the-ress/dmx-box/assets/xlr_pinouts_license.md

This file is licensed under the Creative Commons Attribution-Share Alike 3.0 Unported,
2.5 Generic, 2.0 Generic and 1.0 Generic license.

https://commons.wikimedia.org/wiki/File:XLR_pinouts.svg

Author: https://commons.wikimedia.org/wiki/User:Omegatron
