the-ress/dmx-box/pcb/jlcpcb-gerbers-v1/dmx-box-rounded_drill_map.png

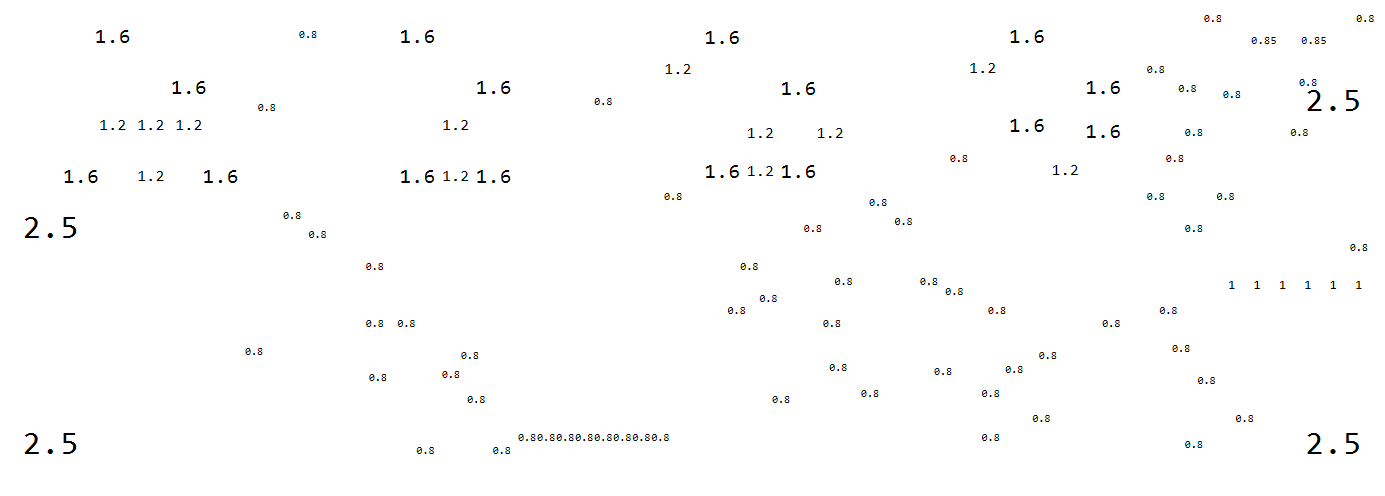
pcb/jlcpcb-gerbers-v1/dmx-box-rounded_drill_map.png
