the-ress/dmx-box/pcb/dmx-box.xlsx

Source: | C:\Users\Tereza\Documents\KiCad\dmx-box\dmx-box.kicad_sch
Date: | 2022-12-01 19:48
Tool: | Eeschema (6.0.9)
Generator: | C:\Program Files\KiCad\6.0\bin\scripting\plugins/bom_csv_grouped_by_value.py
Component Count: | 47
Individual Components:
Item | Qty | Reference(s) | Value | LibPart | Footprint |  |  | Datasheet
 |  | C1 | 100 nF | Device:C | Capacitor_SMD:C_0805_2012Metric |  |  | ~
 |  | C2 | 100 nF | Device:C | Capacitor_SMD:C_0805_2012Metric |  |  | ~
 |  | C3 | 10 uF | Device:C | Capacitor_SMD:C_0805_2012Metric |  |  | ~
 |  | C4 | 100 nF | Device:C | Capacitor_SMD:C_0805_2012Metric |  |  | ~
 |  | C5 | 100 nF | Device:C | Capacitor_SMD:C_0805_2012Metric |  |  | ~
 |  | C6 | 100 nF | Device:C | Capacitor_SMD:C_0805_2012Metric |  |  | ~
 |  | C7 | 100 nF | Device:C | Capacitor_SMD:C_0805_2012Metric |  |  | ~
 |  | C8 | 10 uF | Device:C | Capacitor_SMD:C_0805_2012Metric |  |  | ~
 |  | C9 | 1 uF | Device:C | Capacitor_SMD:C_0805_2012Metric |  |  | ~
 |  | D1 | PWR LED | Device:LED | LED_SMD:LED_0805_2012Metric |  |  | ~
 |  | D2 | DMX OUT LED | Device:LED | LED_SMD:LED_0805_2012Metric |  |  | ~
 |  | D3 | DMX IN LED | Device:LED | LED_SMD:LED_0805_2012Metric |  |  | ~
 |  | D4 | ARTNET IN LED | Device:LED | LED_SMD:LED_0805_2012Metric |  |  | ~
 |  | D5 | WIFI AP LED | Device:LED | LED_SMD:LED_0805_2012Metric |  |  | ~
 |  | D6 | WIFI CLIENT LED | Device:LED | LED_SMD:LED_0805_2012Metric |  |  | ~
 |  | H1 | MountingHole | Mechanical:MountingHole | MountingHole:MountingHole_2.5mm |  |  | ~
 |  | H2 | MountingHole | Mechanical:MountingHole | MountingHole:MountingHole_2.5mm |  |  | ~
 |  | H3 | MountingHole | Mechanical:MountingHole | MountingHole:MountingHole_2.5mm |  |  | ~
 |  | H4 | MountingHole | Mechanical:MountingHole | MountingHole:MountingHole_2.5mm |  |  | ~
 |  | J1 | XLR3_Out | Connector:XLR3_Ground | Connector_Audio:Jack_XLR_Neutrik_NC3FAH2_Horizontal |  |  | ~
 |  | J2 | XLR5_Out | Connector:XLR6 | Connector_Audio:Jack_XLR_Neutrik_NC5FAH_Horizontal |  |  | ~
 |  | J3 | XLR3_In | Connector:XLR3_Ground | Connector_Audio:Jack_XLR_Neutrik_NC3MAH_Horizontal |  |  | ~
 |  | J4 | XLR5_In | Connector:XLR6 | Connector_Audio:Jack_XLR_Neutrik_NC5MAH_Horizontal |  |  | ~
 |  | J5 | USB_B_Micro | Connector:USB_B_Micro | Connector_USB:USB_Micro-B_Molex-105017-0001 |  |  | ~
 |  | J6 | FLASH | Connector_Generic:Conn_01x06 | Connector_PinHeader_2.54mm:PinHeader_1x06_P2.54mm_Vertical |  |  | ~
 |  | Q1 | BCR108 | Transistor_BJT_Pre-Biased_AKL:BCR108 | Package_TO_SOT_SMD_AKL:SOT-23 |  |  | https://www.tme.eu/Document/25cb4b9a0415796c4b98bc4cbdcfd7ac/BCR108WH6327.pdf
 |  | Q2 | BCR108 | Transistor_BJT_Pre-Biased_AKL:BCR108 | Package_TO_SOT_SMD_AKL:SOT-23 |  |  | https://www.tme.eu/Document/25cb4b9a0415796c4b98bc4cbdcfd7ac/BCR108WH6327.pdf
 |  | R1 | 10K | Device:R | Resistor_SMD:R_0805_2012Metric |  |  | ~
 |  | R2 | 20K | Device:R | Resistor_SMD:R_0805_2012Metric |  |  | ~
 |  | R3 | 20K | Device:R | Resistor_SMD:R_0805_2012Metric |  |  | ~
 |  | R4 | 120 | Device:R | Resistor_SMD:R_0805_2012Metric |  |  | ~
 |  | R5 | 120 | Device:R | Resistor_SMD:R_0805_2012Metric |  |  | ~
 |  | R6 | 10K | Device:R | Resistor_SMD:R_0805_2012Metric |  |  | ~
 |  | R7 | 10K | Device:R | Resistor_SMD:R_0805_2012Metric |  |  | ~
 |  | R8 | 330 | Device:R | Resistor_SMD:R_0805_2012Metric |  |  | ~
 |  | R9 | 330 | Device:R | Resistor_SMD:R_0805_2012Metric |  |  | ~
 |  | R10 | 330 | Device:R | Resistor_SMD:R_0805_2012Metric |  |  | ~
 |  | R11 | 330 | Device:R | Resistor_SMD:R_0805_2012Metric |  |  | ~
 |  | R12 | 330 | Device:R | Resistor_SMD:R_0805_2012Metric |  |  | ~
 |  | R13 | 330 | Device:R | Resistor_SMD:R_0805_2012Metric |  |  | ~
 |  | SW1 | SW ZERO | Switch:SW_Push | Tereza_custom:SW_Push_TD-03XA-T |  |  | ~
 |  | SW2 | SW RESET | Switch:SW_Push | Tereza_custom:SW_Push_TD-03XA-T |  |  | ~
 |  | U1 | SN75176AD_Out | Interface_UART:SN75176AD | Package_SO:SOIC-8_3.9x4.9mm_P1.27mm |  |  | http://www.ti.com/lit/ds/symlink/sn75176a.pdf
 |  | U2 | SN75176AD_In | Interface_UART:SN75176AD | Package_SO:SOIC-8_3.9x4.9mm_P1.27mm |  |  | http://www.ti.com/lit/ds/symlink/sn75176a.pdf
 |  | U3 | ESP32-WROOM-32U | RF_Module:ESP32-WROOM-32U | RF_Module:ESP32-WROOM-32U |  |  | https://www.espressif.com/sites/default/files/documentation/esp32-wroom-32d_esp32-wroom-32u_datasheet_en.pdf
 |  | U4 | CH340C | Interface_USB:CH340C | Package_SO:SOIC-16_3.9x9.9mm_P1.27mm |  |  | https://datasheet.lcsc.com/szlcsc/Jiangsu-Qin-Heng-CH340C_C84681.pdf
 |  | U5 | NCP1117-3.3_SOT223 | Regulator_Linear:NCP1117-3.3_SOT223 | Package_TO_SOT_SMD:SOT-223-3_TabPin2 |  |  | http://www.onsemi.com/pub_link/Collateral/NCP1117-D.PDF
Collated Components:
Item | Qty | Reference(s) | Value | LibPart | Footprint | Price | Subtotal | Datasheet
1 | 6 | C1, C2, C4, C5, C6, C7 | 100 nF | Device:C | Capacitor_SMD:C_0805_2012Metric | 2.9 | 17.4 | ~
2 | 2 | C3, C8 | 10 uF | Device:C | Capacitor_SMD:C_0805_2012Metric | 2.1 | 4.2 | ~
3 | 1 | C9 | 1 uF | Device:C | Capacitor_SMD:C_0805_2012Metric | 2.8 | 2.8 | ~
4 | 1 | D1 | PWR LED | Device:LED | LED_SMD:LED_0805_2012Metric | 1.4 | 1.4 | ~
5 | 1 | D2 | DMX OUT LED | Device:LED | LED_SMD:LED_0805_2012Metric | 1.4 | 1.4 | ~
6 | 1 | D3 | DMX IN LED | Device:LED | LED_SMD:LED_0805_2012Metric | 1.4 | 1.4 | ~
7 | 1 | D4 | ARTNET IN LED | Device:LED | LED_SMD:LED_0805_2012Metric | 1.4 | 1.4 | ~
8 | 1 | D5 | WIFI AP LED | Device:LED | LED_SMD:LED_0805_2012Metric | 1.4 | 1.4 | ~
9 | 1 | D6 | WIFI CLIENT LED | Device:LED | LED_SMD:LED_0805_2012Metric | 1.4 | 1.4 | ~
10 | 4 | H1, H2, H3, H4 | MountingHole | Mechanical:MountingHole | MountingHole:MountingHole_2.5mm | 0 | 0 | ~
11 | 1 | J1 | XLR3_Out | Connector:XLR3_Ground | Connector_Audio:Jack_XLR_Neutrik_NC3FAH2_Horizontal | 89.2 | 89.2 | ~
12 | 1 | J2 | XLR5_Out | Connector:XLR6 | Connector_Audio:Jack_XLR_Neutrik_NC5FAH_Horizontal | 141.2 | 141.2 | ~
13 | 1 | J3 | XLR3_In | Connector:XLR3_Ground | Connector_Audio:Jack_XLR_Neutrik_NC3MAH_Horizontal | 72.3 | 72.3 | ~
14 | 1 | J4 | XLR5_In | Connector:XLR6 | Connector_Audio:Jack_XLR_Neutrik_NC5MAH_Horizontal | 158.1 | 158.1 | ~
15 | 1 | J5 | USB_B_Micro | Connector:USB_B_Micro | Connector_USB:USB_Micro-B_Molex-105017-0001 | 24.1 | 24.1 | ~
16 | 1 | J6 | FLASH | Connector_Generic:Conn_01x06 | Connector_PinHeader_2.54mm:PinHeader_1x06_P2.54mm_Vertical | 1.1 | 1.1 | ~
17 | 2 | Q1, Q2 | BCR108 | Transistor_BJT_Pre-Biased_AKL:BCR108 | Package_TO_SOT_SMD_AKL:SOT-23 | 1.7 | 3.4 | https://www.tme.eu/Document/25cb4b9a0415796c4b98bc4cbdcfd7ac/BCR108WH6327.pdf
18 | 3 | R1, R6, R7 | 10K | Device:R | Resistor_SMD:R_0805_2012Metric | 2 | 6 | ~
19 | 2 | R2, R3 | 20K | Device:R | Resistor_SMD:R_0805_2012Metric | 2 | 4 | ~
20 | 2 | R4, R5 | 120 | Device:R | Resistor_SMD:R_0805_2012Metric | 2 | 4 | ~
21 | 6 | R8, R9, R10, R11, R12, R13 | 330 | Device:R | Resistor_SMD:R_0805_2012Metric | 2 | 12 | ~
22 | 1 | SW1 | SW ZERO | Switch:SW_Push | Tereza_custom:SW_Push_TD-03XA-T | 2.4 | 2.4 | ~
23 | 1 | SW2 | SW RESET | Switch:SW_Push | Tereza_custom:SW_Push_TD-03XA-T | 2.4 | 2.4 | ~
24 | 1 | U1 | SN75176AD_Out | Interface_UART:SN75176AD | Package_SO:SOIC-8_3.9x4.9mm_P1.27mm | 28 | 28 | http://www.ti.com/lit/ds/symlink/sn75176a.pdf
25 | 1 | U2 | SN75176AD_In | Interface_UART:SN75176AD | Package_SO:SOIC-8_3.9x4.9mm_P1.27mm | 28 | 28 | http://www.ti.com/lit/ds/symlink/sn75176a.pdf
26 | 1 | U3 | ESP32-WROOM-32U | RF_Module:ESP32-WROOM-32U | RF_Module:ESP32-WROOM-32U | 182.1 | 182.1 | https://www.espressif.com/sites/default/files/documentation/esp32-wroom-32d_esp32-wroom-32u_datasheet_en.pdf
27 | 1 | U4 | CH340C | Interface_USB:CH340C | Package_SO:SOIC-16_3.9x9.9mm_P1.27mm | 16.5 | 16.5 | https://datasheet.lcsc.com/szlcsc/Jiangsu-Qin-Heng-CH340C_C84681.pdf
28 | 1 | U5 | NCP1117-3.3_SOT223 | Regulator_Linear:NCP1117-3.3_SOT223 | Package_TO_SOT_SMD:SOT-223-3_TabPin2 | 10.4 | 10.4 | http://www.onsemi.com/pub_link/Collateral/NCP1117-D.PDF
 | 1 |  |  |  | Board | 37.9 | 37.9
 | 1 |  |  |  | Box | 58.9 | 58.9
 |  |  |  |  |  |  | 914.8
