the-ress/dmx-box/pcb/dmx-box.step

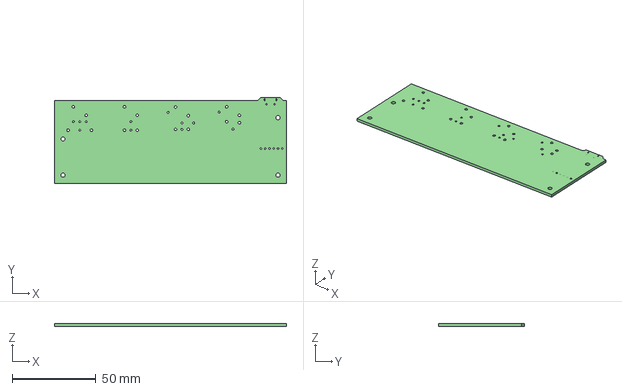
[picture p3: CAD file, 2025-04-09]
pcb/dmx-box.step
138.4 x 51.4 x 1.60 mm
