the-ress/dmx-box/pcb/dmx-box.kicad_pcb

## KiCad design pcb/dmx-box.kicad_pcb (2025-04-09)

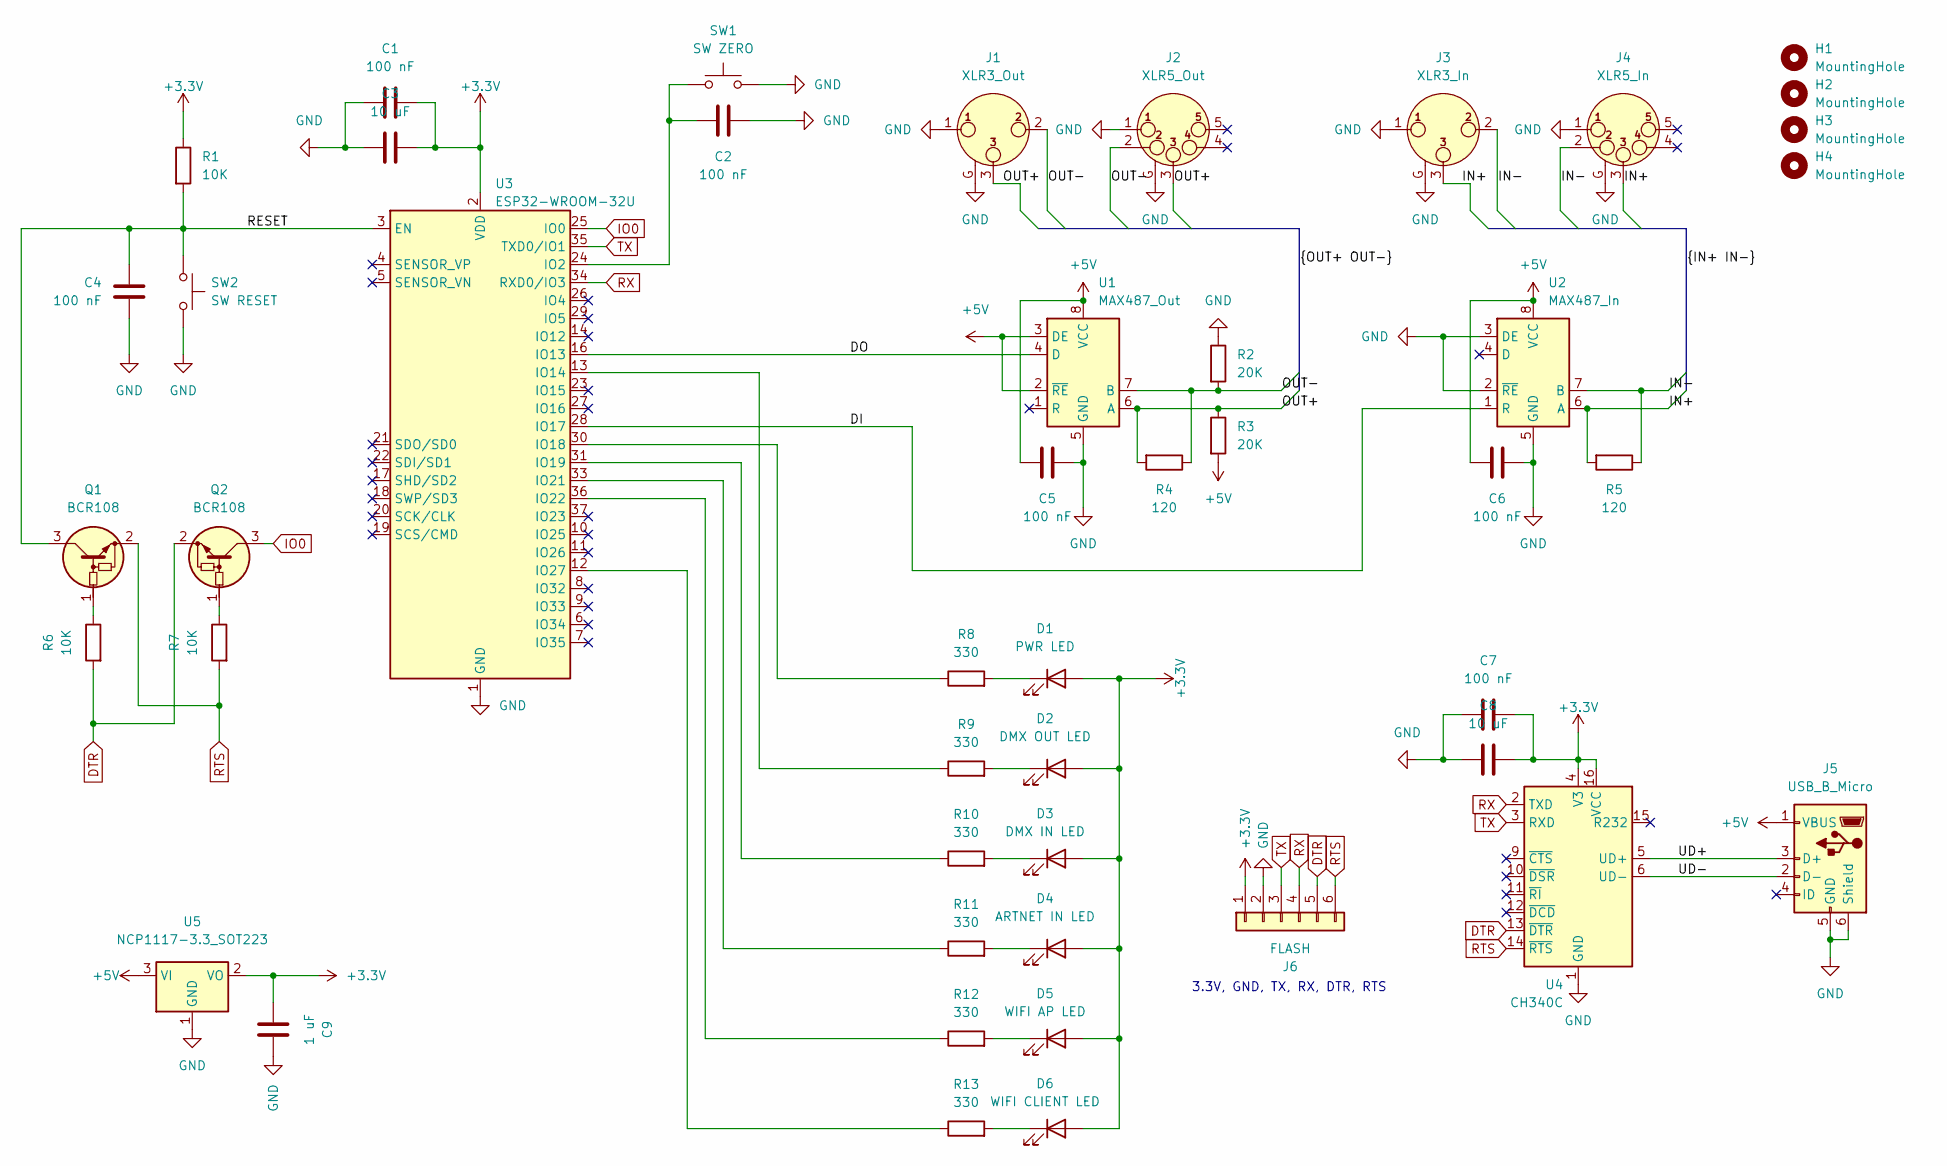
[picture p4: schematic dmx-box.kicad_sch]

Parts:
C1, C2, C4, C5, C6, C7: 100 nF; C_0805_2012Metric
C3, C8: 10 uF; C_0805_2012Metric
C9: 1 uF; C_0805_2012Metric
D1: PWR LED; LED_0805_2012Metric
D2: DMX OUT LED; LED_0805_2012Metric
D3: DMX IN LED; LED_0805_2012Metric
D4: ARTNET IN LED; LED_0805_2012Metric
D5: WIFI AP LED; LED_0805_2012Metric
D6: WIFI CLIENT LED; LED_0805_2012Metric
H1, H2, H3, H4: MountingHole; MountingHole_2.5mm
J1: XLR3_Out; Jack_XLR_Neutrik_NC3FAH2_Horizontal
J2: XLR5_Out; Jack_XLR_Neutrik_NC5FAH_Horizontal
J3: XLR3_In; Jack_XLR_Neutrik_NC3MAH_Horizontal
J4: XLR5_In; Jack_XLR_Neutrik_NC5MAH_Horizontal
J5: USB_B_Micro; USB_Micro-B_Molex-105017-0001
J6: FLASH; PinHeader_1x06_P2.54mm_Vertical
Q1, Q2: BCR108; SOT-23
R1, R6, R7: 10K; R_0805_2012Metric
R2, R3: 20K; R_0805_2012Metric
R4, R5: 120; R_0805_2012Metric
R8, R9, R10, R11, R12, R13: 330; R_0805_2012Metric
SW1: SW ZERO; SW_Push_TD-03XA-T
SW2: SW RESET; SW_Push_TD-03XA-T
U1: MAX487_Out; SOIC-8_3.9x4.9mm_P1.27mm
U2: MAX487_In; SOIC-8_3.9x4.9mm_P1.27mm
U3: ESP32-WROOM-32U
U4: CH340C; SOIC-16_3.9x9.9mm_P1.27mm
U5: NCP1117-3.3_SOT223; SOT-223-3_TabPin2

Connections:
+3.3V: C1.2, C3.2, C7.2, C8.2, C9.1, D1.2 (A), D2.2 (A), D3.2 (A), D4.2 (A), D5.2 (A), D6.2 (A), J6.1, R1.1, U3.2 (VDD), U4.4 (V3), U4.16 (VCC), U5.2 (VO)
+5V: C5.1, C6.1, J5.1 (VBUS), R3.2, U1.2 (~RE), U1.3 (DE), U1.8 (VCC), U2.8 (VCC), U5.3 (VI)
/DI: U2.1 (R), U3.28 (IO17)
/DO: U1.4 (D), U3.16 (IO13)
/IN+: J3.3, J4.3, R5.2, U2.6 (A)
/IN-: J3.2, J4.2, R5.1, U2.7 (B)
/OUT+: J1.3, J2.3, R3.1, R4.2, U1.6 (A)
/OUT-: J1.2, J2.2, R2.2, R4.1, U1.7 (B)
/RESET: C4.1, Q1.3 (C), R1.2, SW2.1, U3.3 (EN)
/UD+: J5.3 (D+), U4.5 (UD+)
/UD-: J5.2 (D-), U4.6 (UD-)
DTR: J6.5, Q2.2 (E), R6.2, U4.13 (~DTR)
GND: C1.1, C2.1, C3.1, C4.2, C5.2, C6.2, C7.1, C8.1, C9.2, J1.1, J1.G, J2.1, J2.G, J3.1, J3.G, J4.1, J4.G, J5.5 (GND), J5.6 (Shield), J6.2, R2.1, SW1.2, SW2.2, U1.5 (GND), U2.2 (~RE), U2.3 (DE), U2.5 (GND), U3.1 (GND), U3.15 (GND), U3.38 (GND), U3.39 (GND), U4.1 (GND), U5.1 (GND)
IO0: Q2.3 (C), U3.25 (IO0)
unnamed: D1.1 (K), R8.2
unnamed: D2.1 (K), R9.2
unnamed: D3.1 (K), R10.2
unnamed: D4.1 (K), R11.2
unnamed: D5.1 (K), R12.2
unnamed: D6.1 (K), R13.2
unnamed: Q1.1 (B), R6.1
unnamed: Q2.1 (B), R7.1
unnamed: C2.2, SW1.1, U3.24 (IO2)
unnamed: R9.1, U3.13 (IO14)
unnamed: R8.1, U3.30 (IO18)
unnamed: R10.1, U3.31 (IO19)
unnamed: R11.1, U3.33 (IO21)
unnamed: R12.1, U3.36 (IO22)
unnamed: R13.1, U3.12 (IO27)
RTS: J6.6, Q1.2 (E), R7.2, U4.14 (~RTS)
RX: J6.4, U3.34 (RXD0/IO3), U4.2 (TXD)
TX: J6.3, U3.35 (TXD0/IO1), U4.3 (RXD)

Notes on the sheet:
3.3V, GND, TX, RX, DTR, RTS

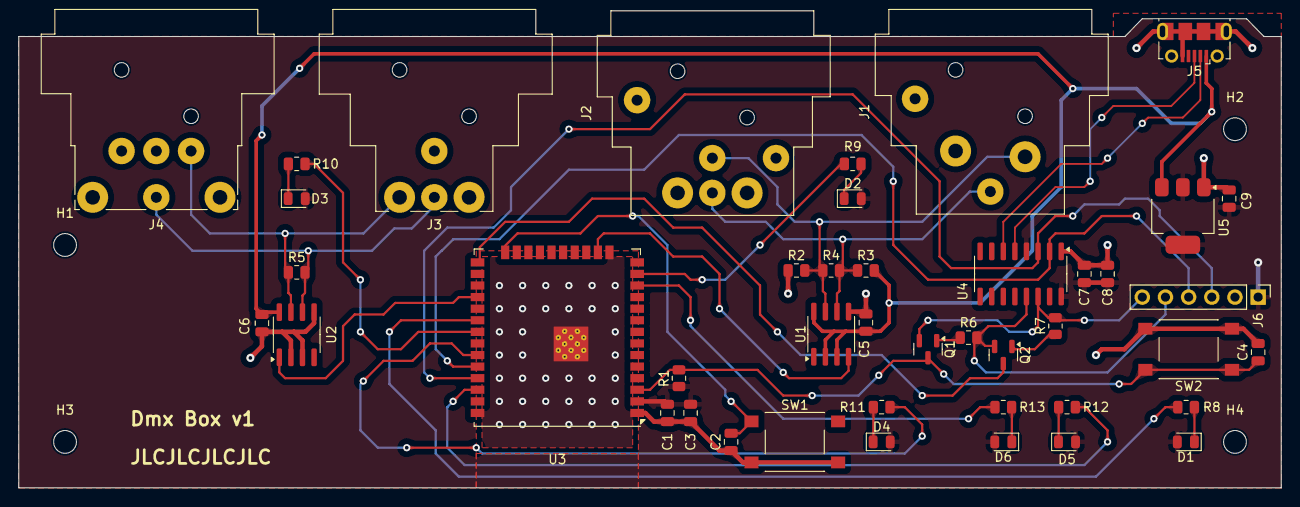
[picture p5: board dmx-box.kicad_pcb from above]

Board: 2 copper layers, 138.4 x 51.4 mm, 47 parts (0 on the bottom side), 32 nets.
