the-ress/dmx-box/components/dmxbox_dmx/include/dmxbox_dmx_send.h

#pragma once
#include "dmxbox_const.h"
#include "esp_dmx.h"

extern portMUX_TYPE dmxbox_dmx_out_spinlock;
extern uint8_t dmxbox_dmx_out_data[DMX_PACKET_SIZE_MAX];

void dmxbox_dmx_send_task(void *parameter);
void dmxbox_set_dmx_out_active(bool state);
void dmxbox_dmx_send_get_data(uint8_t data[DMX_CHANNEL_COUNT]);
