the-ress/dmx-box/(commit log)

2024-07-20 enlarge nvs partition
    [partitions.csv]
2024-07-20 add artnet settings ui
    [partitions.csv]
2025-03-12 test all leds on startup
2025-04-09 add kicad files
    [dmx-box-NPTH.drl, dmx-box-PTH.drl, dmx-box-rounded-B_Cu.gbl, dmx-box-rounded-B_Mask.gbs, dmx-box-rounded-B_Paste.gbp, dmx-box-rounded-B_Silkscreen.gbo, dmx-box-rounded-Edge_Cuts.gm1, dmx-box-rounded-F_Cu.gtl]
